lwoodbury/ATTiny-RGB_lamp/README.md

# ATTiny-RGB_lamp
 Programming an ATTiny84 with Arduino to make an RGB mood lamp

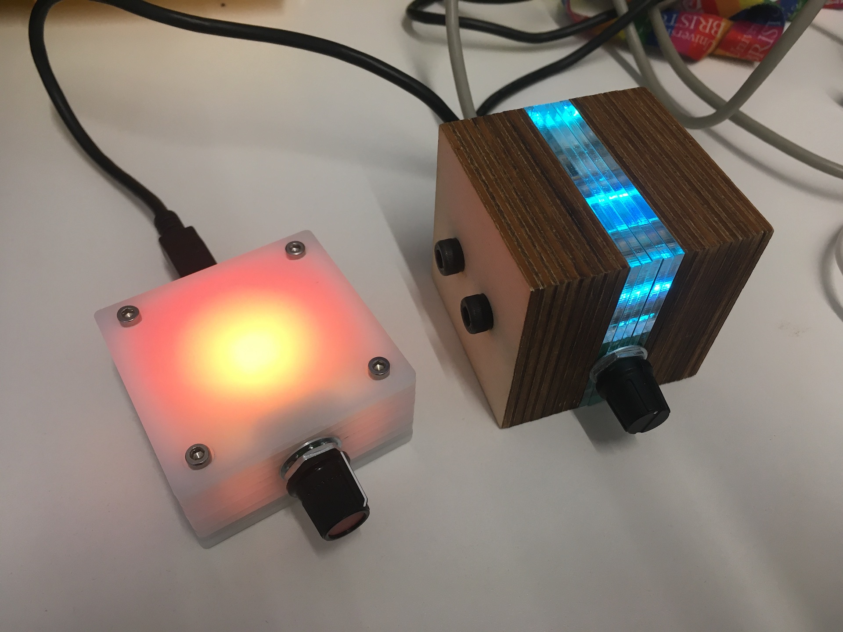
[picture p1: 2xcomplete3.JPG]

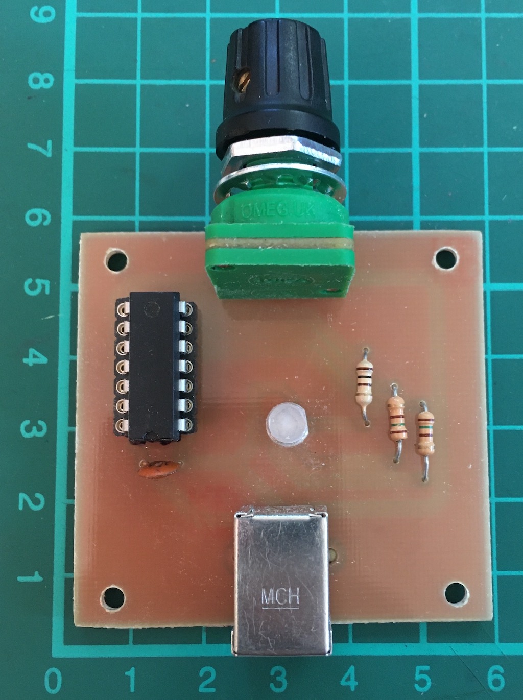
[picture p2: PCB.JPG]
