lwoodbury/ATTiny-RGB_lamp/Programmer/notes.rtfd/TXT.rtf

Micro as ISP

ATtiny84

Pin 1 to V++
Pin 4 to 10
Pin 7 to MOSI
Pin 8 to MISO
Pin 9 to SCK

¬
