lwoodbury/ATTiny-RGB_lamp/circuit/ATTinyRGBdimmer_bb.png

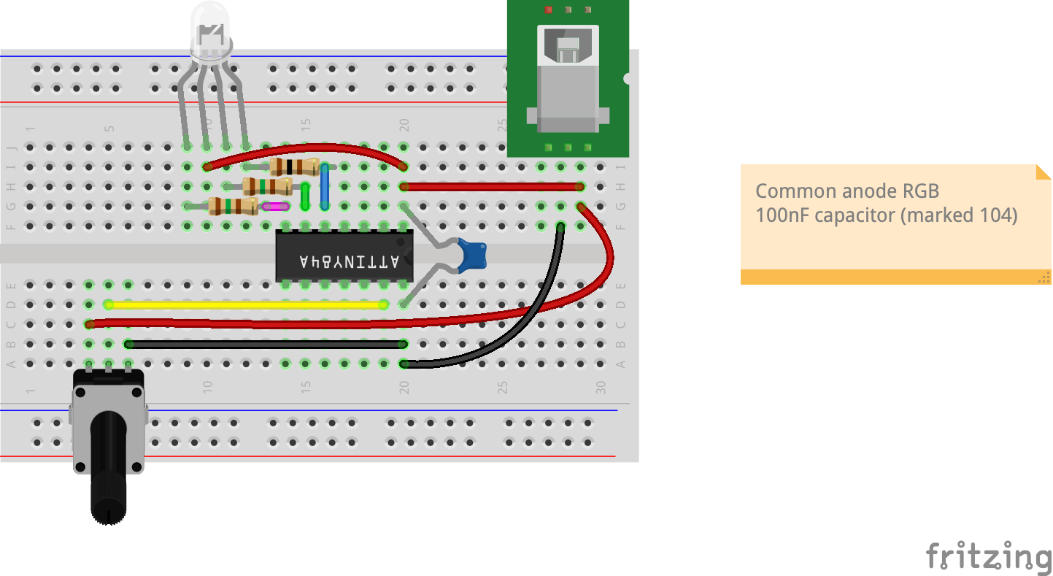
circuit/ATTinyRGBdimmer_bb.png
