lwoodbury/ATTiny-RGB_lamp/circuit/ATTinyRGBdimmerStrip_bb.png

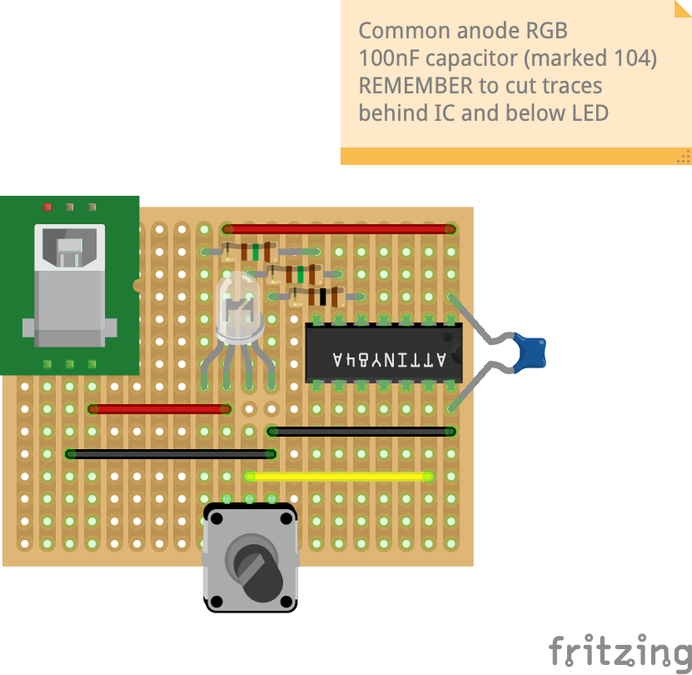
circuit/ATTinyRGBdimmerStrip_bb.png
