lwoodbury/ATTiny-RGB_lamp/circuit/ATtinyRGBLampPCB.png

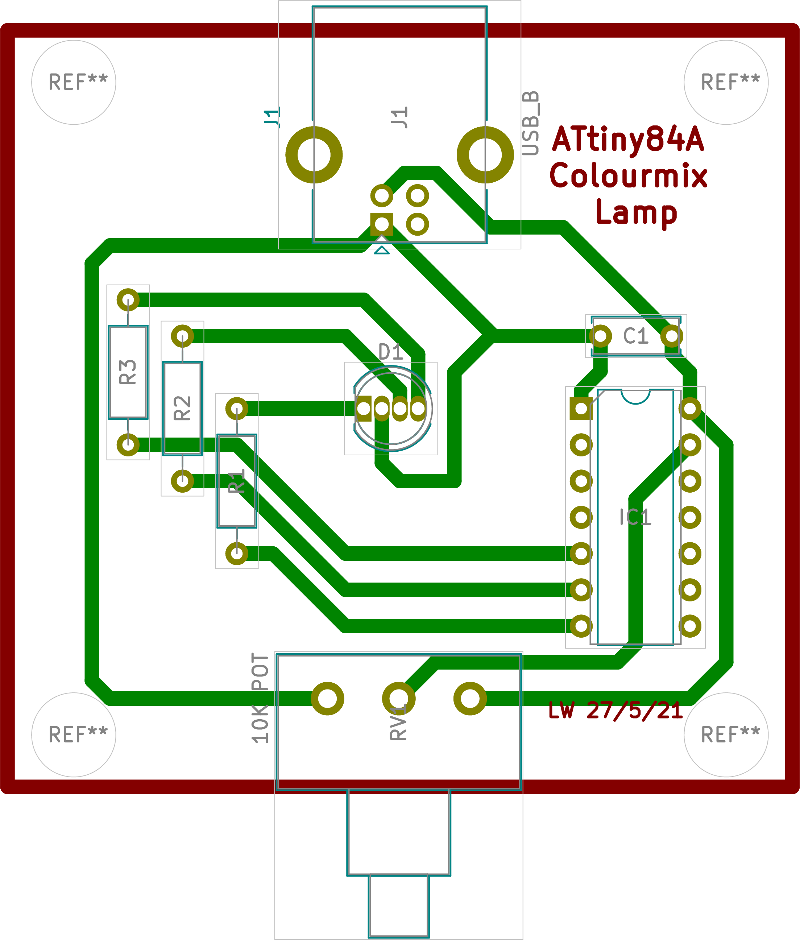
circuit/ATtinyRGBLampPCB.png
