lwoodbury/ATTiny-RGB_lamp/Programmer/ATtiny84 programmer micro_bb.png

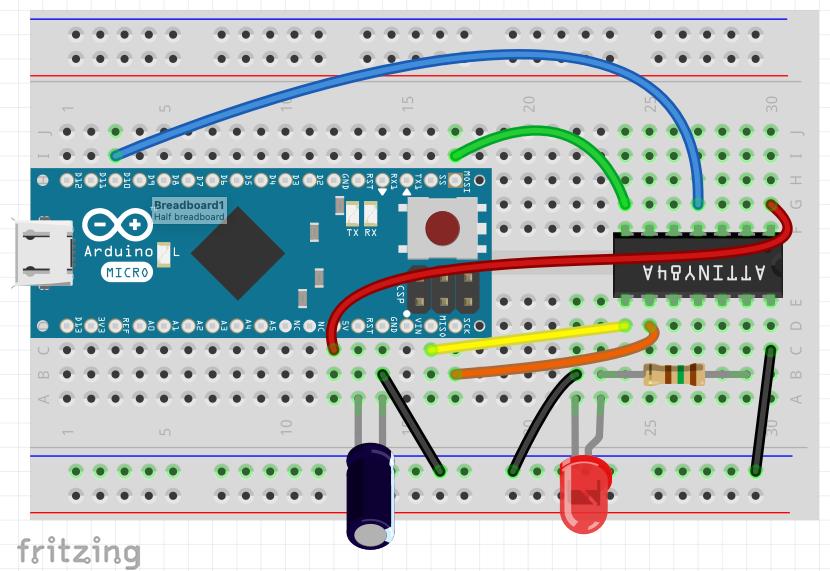
Programmer/ATtiny84 programmer micro_bb.png
