lwoodbury/ATTiny-RGB_lamp/Programmer/ATtiny84 programmer_bb.png

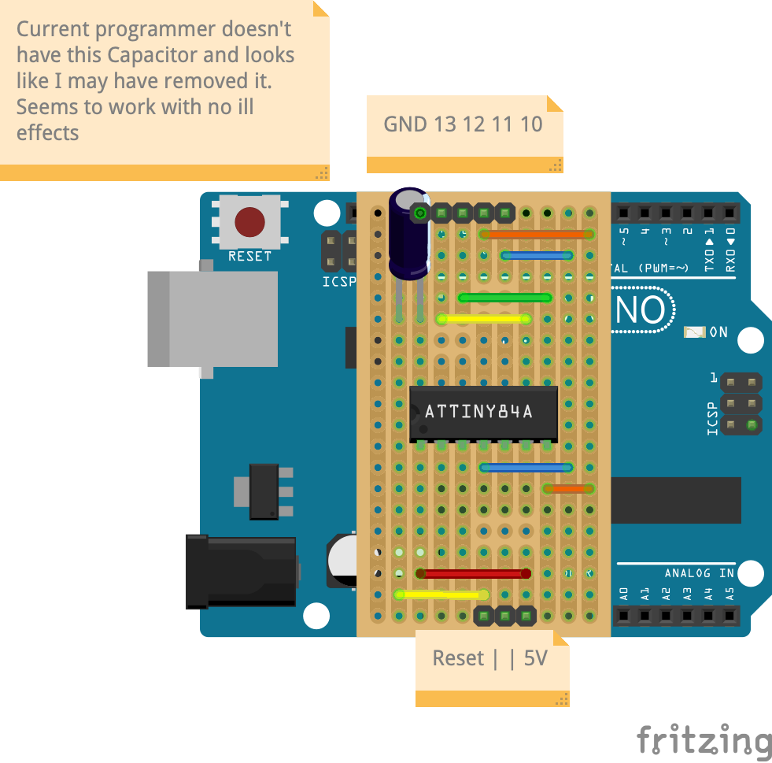
Programmer/ATtiny84 programmer_bb.png
