lwoodbury/ATTiny-RGB_lamp/Programmer/notes.rtfd/unknown.png

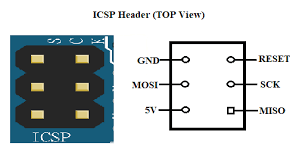
Programmer/notes.rtfd/unknown.png
