lwoodbury/ATTiny-RGB_lamp/Programmer/PCB/ATtiny84Programmer/ATtiny84Programmer-brd.png

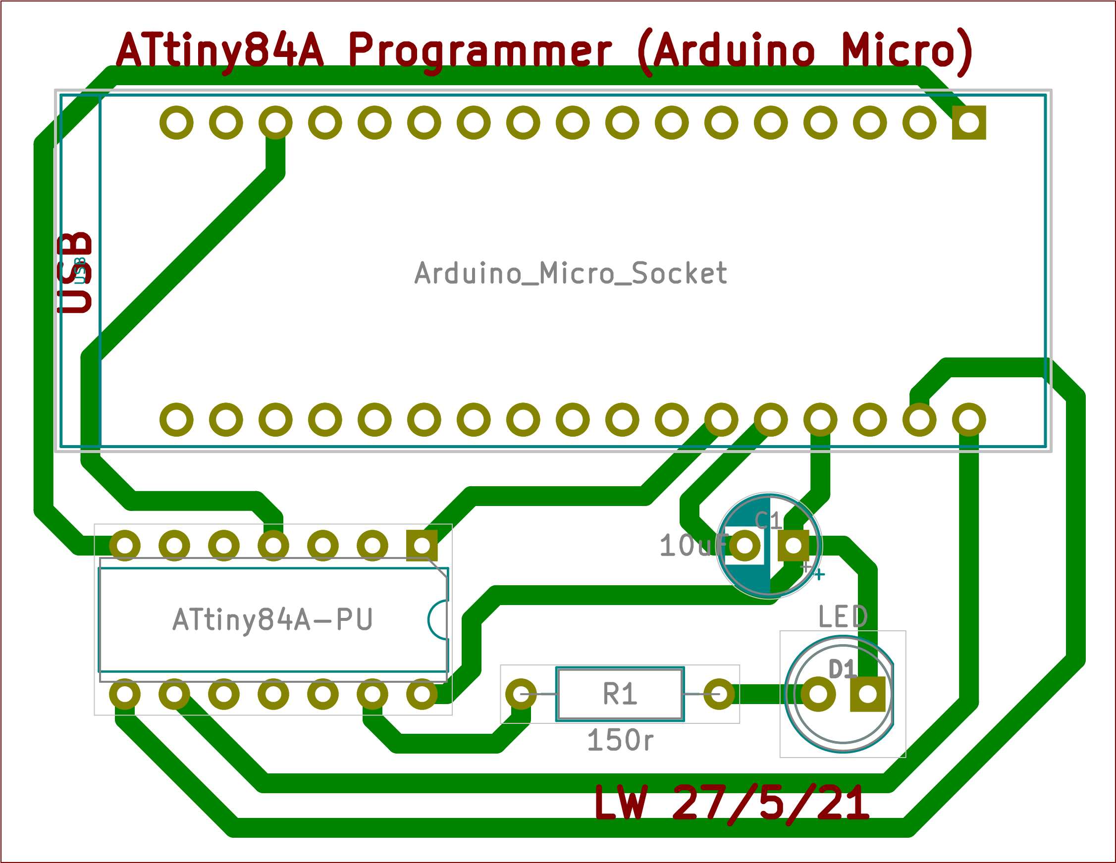
Programmer/PCB/ATtiny84Programmer/ATtiny84Programmer-brd.png
