lwoodbury/ATTiny-RGB_lamp/Programmer/Resources/F6E6WL7IY0FSUXX.webp

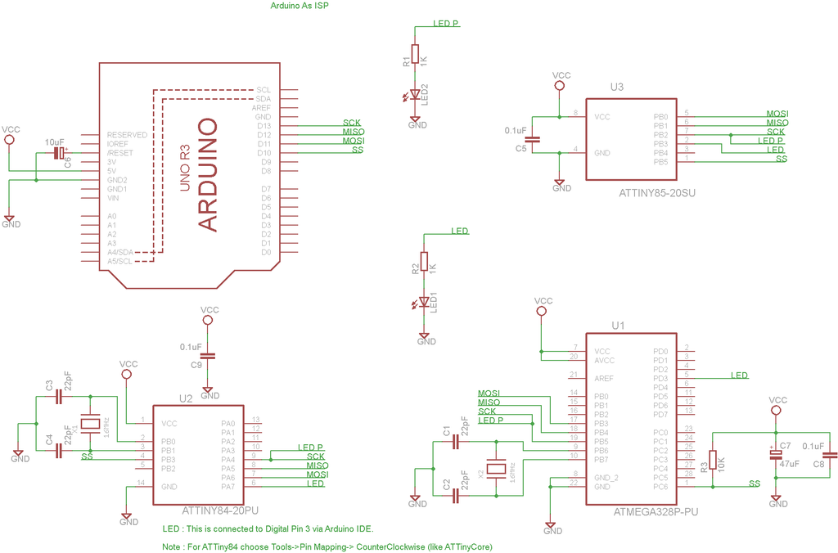
Programmer/Resources/F6E6WL7IY0FSUXX.webp
