lwoodbury/ATTiny-RGB_lamp/Programmer/Resources/FC7W5OXIZ6BTUVY.webp

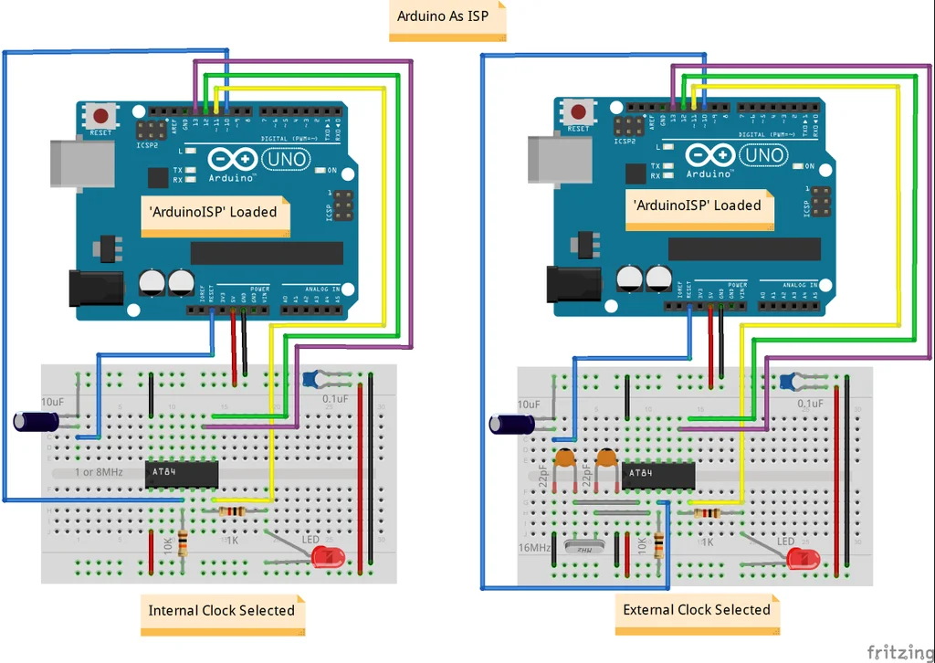
Programmer/Resources/FC7W5OXIZ6BTUVY.webp
