lwoodbury/ATTiny-RGB_lamp/Programmer/Resources/FW9S4BFIZ6BTUVL.webp

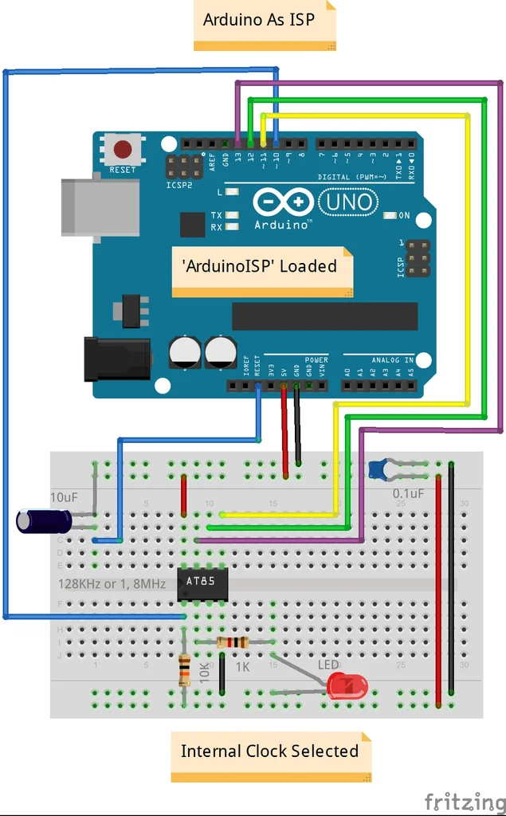
Programmer/Resources/FW9S4BFIZ6BTUVL.webp
