lwoodbury/ATTiny-RGB_lamp/Programmer/Resources/s-l1600.jpg

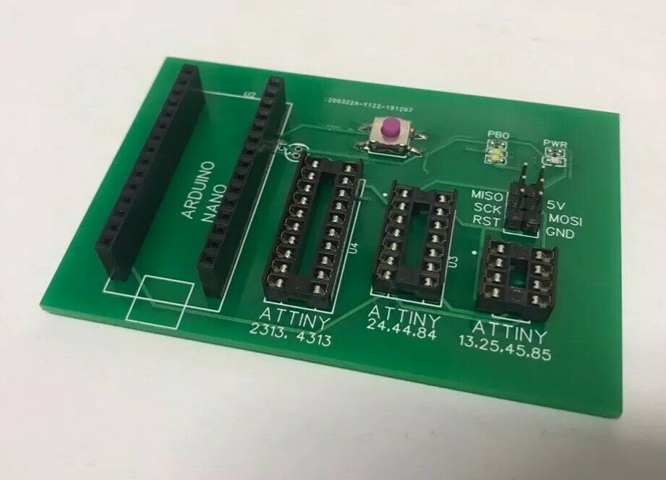
Programmer/Resources/s-l1600.jpg
