lwoodbury/ATTiny-RGB_lamp/Materials/BOM.xlsx

Item | Units | Unit Cost | Total | Link
Lamp
USB Micro Socket Breakout (x10) | 0 | 5.19 | 0 | https://www.amazon.co.uk/dp/B07R9SMJKF?psc=1&smid=A2BTSZU32SZ5O4&ref_=chk_typ_imgToDp
USB B through hole socket | 100 | 0.66 | 66 | https://uk.farnell.com/lumberg/2411-06/usb-conn-2-0-type-b-r-a-rcpt-4pos/dp/3490505
Attiny84a | 100 | 1.27 | 127 | https://uk.farnell.com/microchip/attiny84a-pu/mcu-8bit-attiny-20mhz-dip-14/dp/1972172?ost=ATTINY84A-PU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
RGB LED CA | 100 | 0.34 | 34 | https://uk.farnell.com/dialight/521-8559f/led-rgb-2-5-1-9-1-45cd-5mm-th/dp/3514768
150r Resistor (1/4w Carbon Film) x10 | 10 | 0.027 | 0.27 | https://uk.farnell.com/multicomp/mcf-0-25w-150r/res-150r-5-250mw-axial-carbon/dp/9339175?ost=mcf+0.25w
100r resistor (1/4W Carbon Film) x10 | 10 | 0.026 | 0.26 | https://uk.farnell.com/multicomp/mcf-0-25w-100r/res-100r-5-250mw-axial-carbon/dp/9339043
100nF capacitor (104) x10 | 10 | 0.23 | 2.3 | https://uk.farnell.com/multicomp/mcfyu6104z6/cap-0-1-f-50v-y5v/dp/9411887
10K Linear Potentiometer (already have stock) | 0 | 1.65 | 0 | https://www.rapidonline.com/omeg-eco10klin-10k-eco-16mm-linear-single-control-65-1404
Stripboard | 10 | 4.56 | 45.6 | https://uk.farnell.com/kelan/147899/stripboard-single-sided/dp/147899?st=stripboard
Stripboard track cutter | 5 | 1.55 | 7.75 | https://cpc.farnell.com/duratool/3360568a/cutter-track/dp/PC01227?MER=sy-me-pd-mi-alte
14-Pin DIP Socket | 100 | 0.12 | 12 | https://uk.farnell.com/te-connectivity/1-2199298-3/ic-socket-dip-14pos-th/dp/2445621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
Hook up wire
PCB Fab
Programmer
14-Pin DIP Socket | 30 | 0.12 | 3.6 | https://uk.farnell.com/te-connectivity/1-2199298-3/ic-socket-dip-14pos-th/dp/2445621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
10uF Electrolytic Capacitor | 30 | 0.05 | 1.5 | https://uk.farnell.com/multicomp/mcmhr16v106m4x7/cap-10-f-16v-20/dp/9452591?st=10uf%20electrolytic
Hookup wire |  |  | 0
PCB Fab
