lwoodbury/ATTiny-RGB_lamp/Materials/cost.xlsx

Item | Cost per unit
Diet Arduino (PCB)
ATtiny84 chip | £1.27
USB B through hole socket | £0.66 |  | USB B through hole socket | USB B through hole socket | USB B through hole socket | USB B through hole socket | USB B through hole socket | USB B through hole socket | USB B through hole socket | USB B through hole socket | USB B through hole socket | USB B through hole socket | USB B through hole socket | USB B through hole socket | USB B through hole socket | USB B through hole socket | USB B through hole socket | USB B through hole socket | USB B through hole socket | USB B through hole socket | USB B through hole socket | USB B through hole socket | USB B through hole socket | USB B through hole socket | USB B through hole socket | USB B through hole socket | USB B through hole socket | USB B through hole socket | USB B through hole socket | USB B through hole socket | USB B through hole socket | USB B through hole socket | USB B through hole socket | USB B through hole socket | USB B through hole socket | USB B through hole socket | USB B through hole socket | USB B through hole socket | USB B through hole socket | USB B through hole socket | USB B through hole socket | USB B through hole socket | USB B through hole socket | USB B through hole socket | USB B through hole socket | USB B through hole socket | USB B through hole socket | USB B through hole socket | USB B through hole socket | USB B through hole socket | USB B through hole socket | USB B through hole socket | USB B through hole socket | USB B through hole socket | USB B through hole socket | USB B through hole socket | USB B through hole socket
100nF Capacitor | £0.23
3x resistors | £0.01
RGB LED | £0.34
10K potentiometer (already have stock) | £1.65
14-Pin DIP socket | £0.12
Knob | £0.25
PCB Fab | ???
TOTAL | £4.53
TOTAL |  | £0.00
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
