lwoodbury/ATTiny-RGB_lamp/circuit/PCB/ATtinyRGBLamp_milled/ATtinyRGBLamp.step

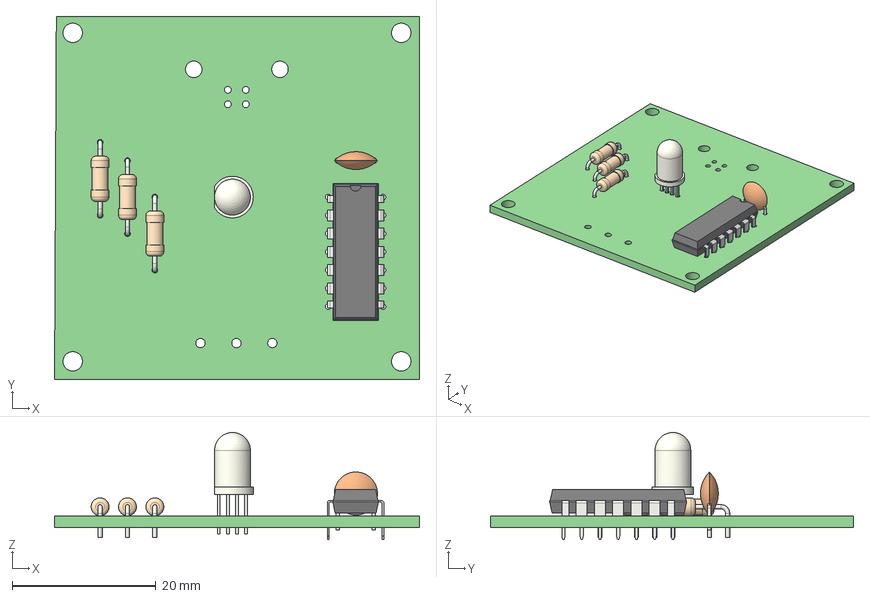
[picture p14: CAD file, 2022-06-08]
circuit/PCB/ATtinyRGBLamp_milled/ATtinyRGBLamp.step
50.8 x 50.5 x 14.9 mm
