lwoodbury/ATTiny-RGB_lamp/(list of files, drawings)

Other design files:
circuit/ATTinyRGBdimmer.fzz
circuit/ATTinyRGBdimmerStrip.fzz
Programmer/ATtiny84 programmer micro.fzz
Programmer/ATtiny84 programmer.fzz
