lwoodbury/ATTiny-RGB_lamp/circuit/PCB/ATtinyRGBLamp_PCBtrain/ATtinyRGBLamp.kicad_pcb

## KiCad design circuit/PCB/ATtinyRGBLamp_PCBtrain/ATtinyRGBLamp.kicad_pcb (2022-06-08)

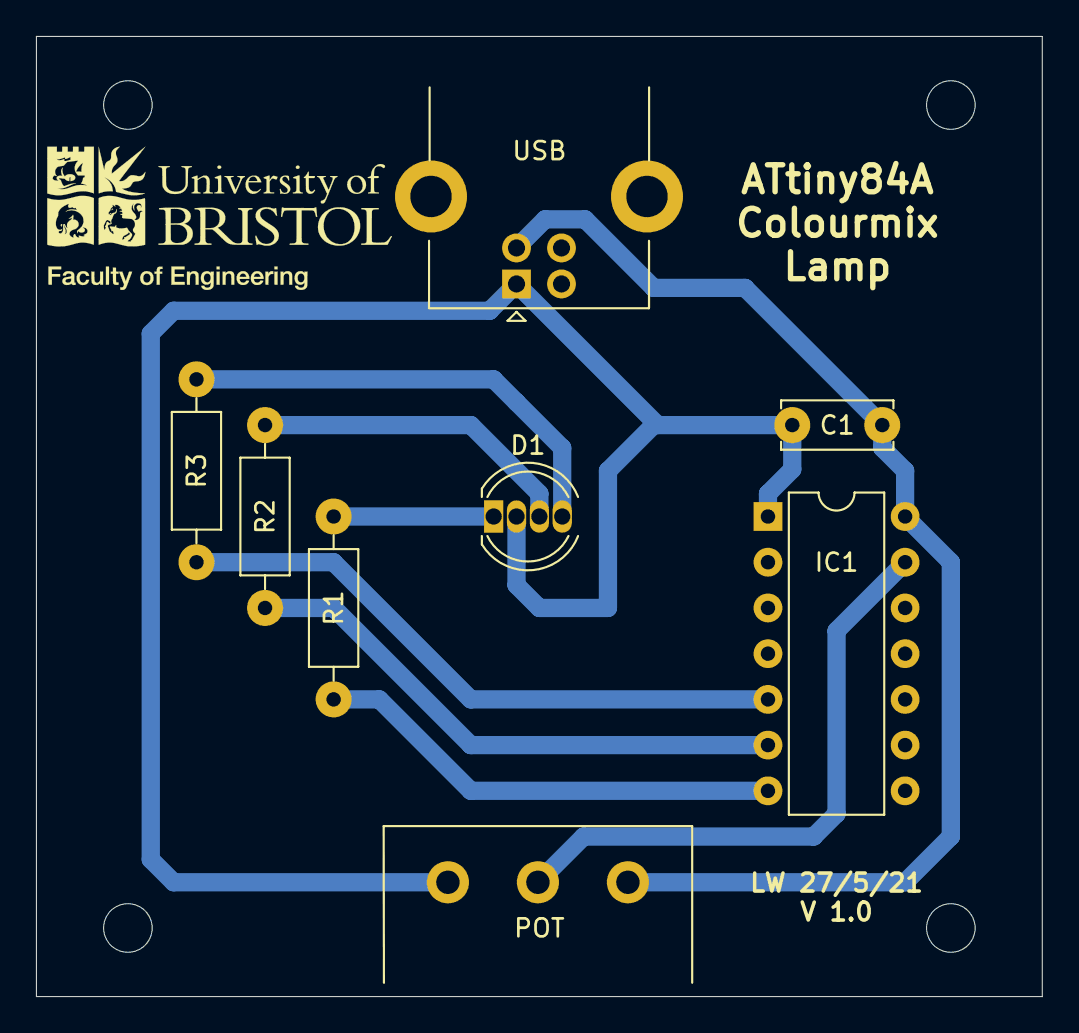
[picture p15: board ATtinyRGBLamp.kicad_pcb from above]

Board: 2 copper layers, 55.9 x 53.3 mm, 8 parts (0 on the bottom side), 9 nets.

Parts:
C1: 100nF; C_Disc_D6.0mm_W2.5mm_P5.00mm
D1: LED_RGBA; LED_D5.0mm-4_RGB
IC1: ATtiny84A-PU; DIP-14_W7.62mm
POT: 10K POT; Potentiometer_Omeg_PC16BU_Horizontal
R1: 150R; R_Axial_DIN0207_L6.3mm_D2.5mm_P10.16mm_Horizontal
R2, R3: 100R; R_Axial_DIN0207_L6.3mm_D2.5mm_P10.16mm_Horizontal
USB: USB_B; USB_B_Lumberg_2411_02_Horizontal

Connections:
+5V: C1.2, D1.2, IC1.1, POT.1, USB.1
GND: C1.1, IC1.14, POT.3, USB.4
unnamed: D1.1, R1.1
unnamed: D1.3, R2.1
unnamed: D1.4, R3.1
unnamed: IC1.5, R3.2
unnamed: IC1.6, R2.2
unnamed: IC1.7, R1.2
unnamed: IC1.13, POT.2
