lwoodbury/ATTiny-RGB_lamp/Programmer/PCB/ATtiny84Programmer/ATtiny84Programmer.kicad_pcb

## KiCad design Programmer/PCB/ATtiny84Programmer/ATtiny84Programmer.kicad_pcb (2022-06-08)

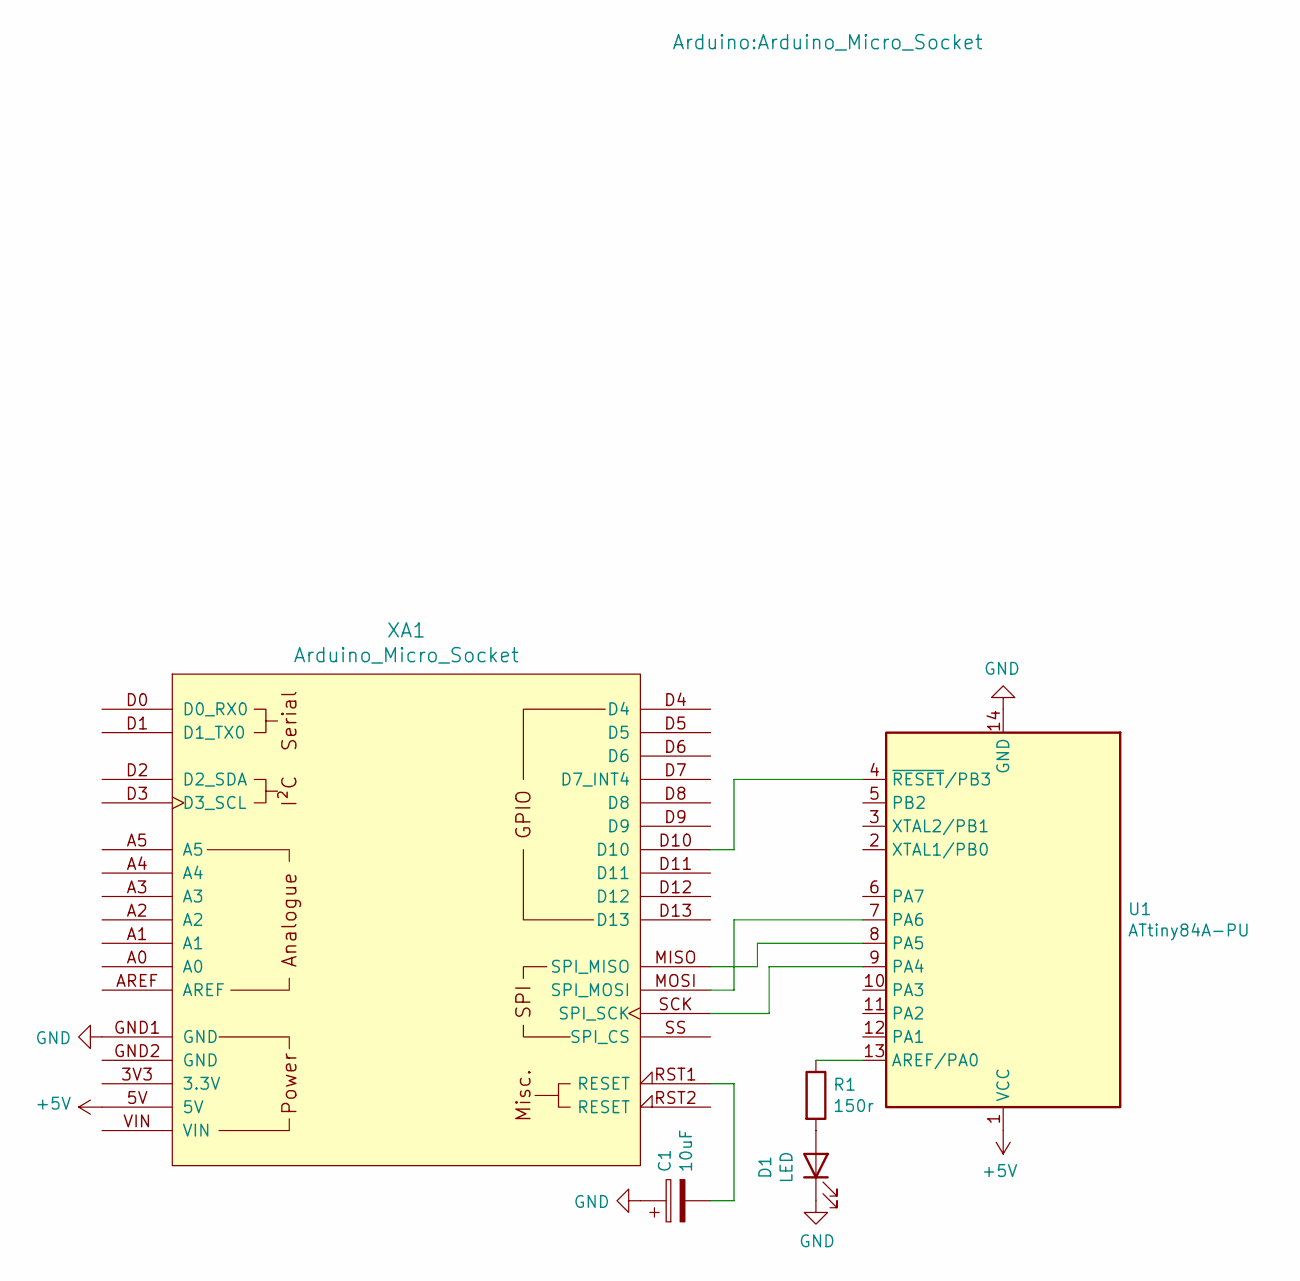
[picture p16: schematic ATtiny84Programmer.sch]

Parts:
C1: 10uF; CP_Radial_D5.0mm_P2.50mm
D1: LED; LED_D5.0mm
R1: 150r; R_Axial_DIN0207_L6.3mm_D2.5mm_P10.16mm_Horizontal
U1: ATtiny84A-PU; DIP-14_W7.62mm
XA1: Arduino_Micro_Socket

Connections:
+5V: U1.1 (VCC), XA1.5V
GND: C1.1, D1.1 (K), U1.14 (GND), XA1.GND1 (GND)
unnamed: C1.2, XA1.RST1 (RESET)
unnamed: D1.2 (A), R1.2
unnamed: R1.1, U1.13 (AREF/PA0)
unnamed: U1.4 (~RESET~/PB3), XA1.D10
unnamed: U1.7 (PA6), XA1.MOSI (SPI_MOSI)
unnamed: U1.8 (PA5), XA1.MISO (SPI_MISO)
unnamed: U1.9 (PA4), XA1.SCK (SPI_SCK)

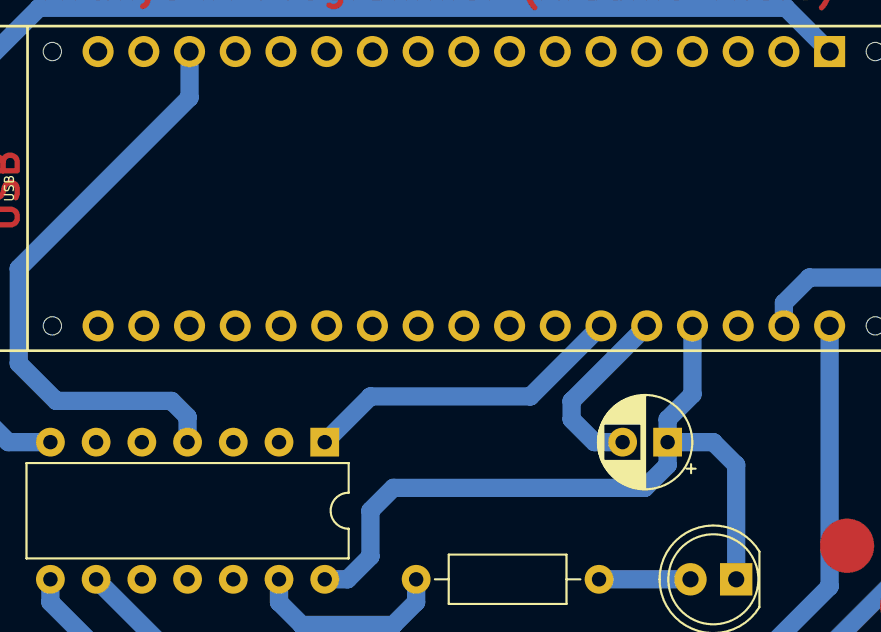
[picture p17: board ATtiny84Programmer.kicad_pcb from above]

Board: 2 copper layers, 5 parts (0 on the bottom side), 9 nets.
