lwoodbury/ATTiny-RGB_lamp/(commit log)

2022-06-08 add PCB img
2022-06-08 Resize PCB img
